MorrisMA/MAM65C02-Processor-Core/Docs/Images/M65C02-TestBoard-20130703.JPG

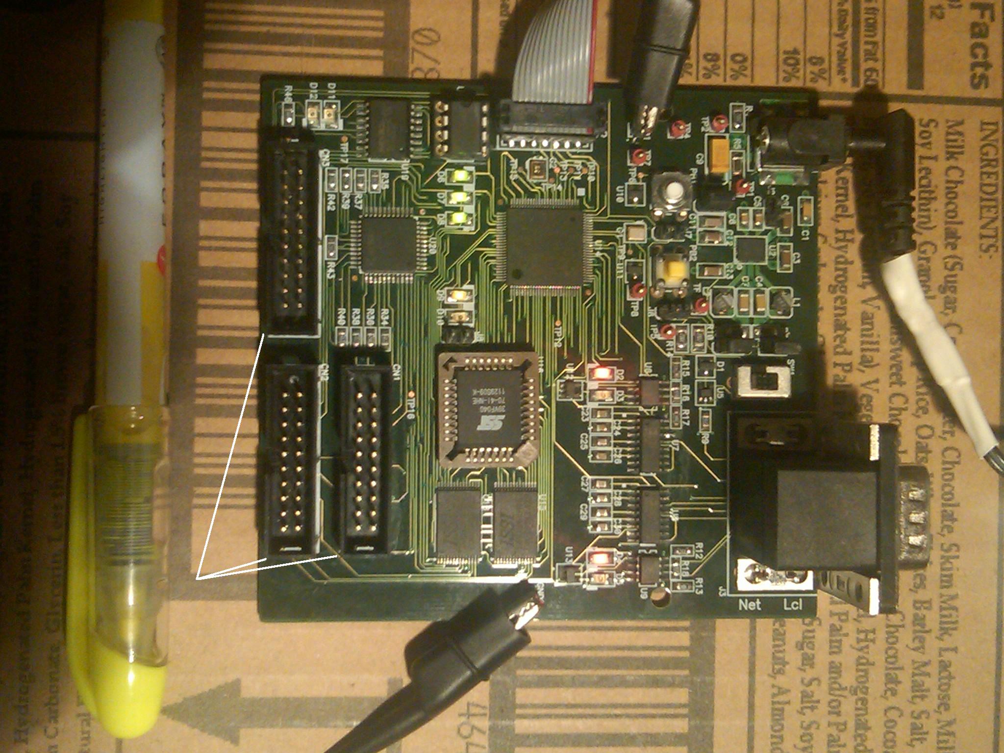
Docs/Images/M65C02-TestBoard-20130703.JPG
