MorrisMA/MAM65C02-Processor-Core/Docs/Images/M65C02_FlowControl_Immediate_Cycles.JPG

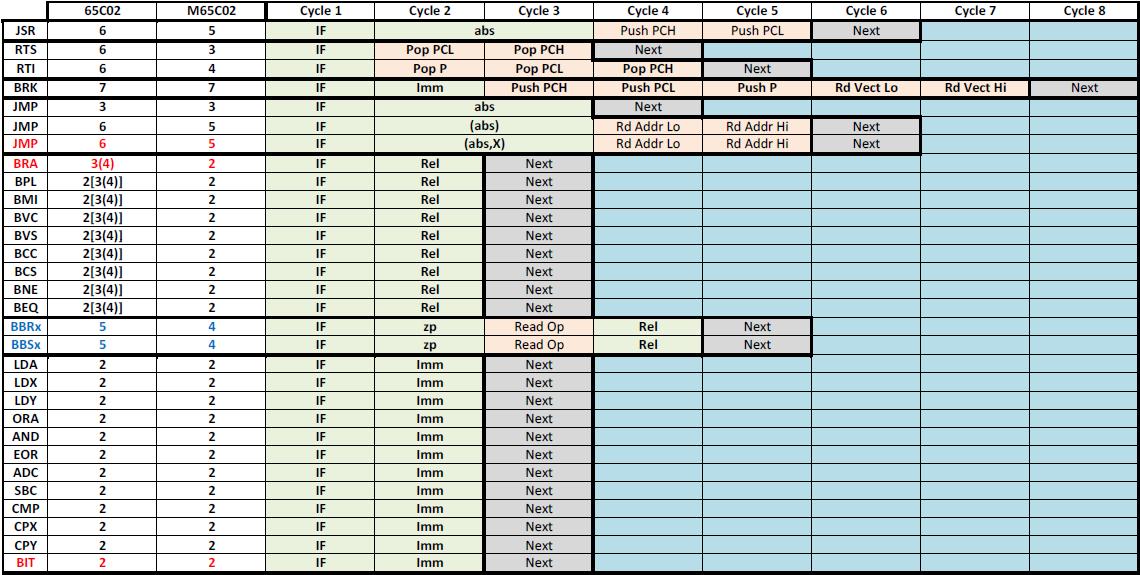
Docs/Images/M65C02_FlowControl_Immediate_Cycles.JPG
