MorrisMA/MAM65C02-Processor-Core/Docs/Images/FSM-BubbleDiagram.JPG

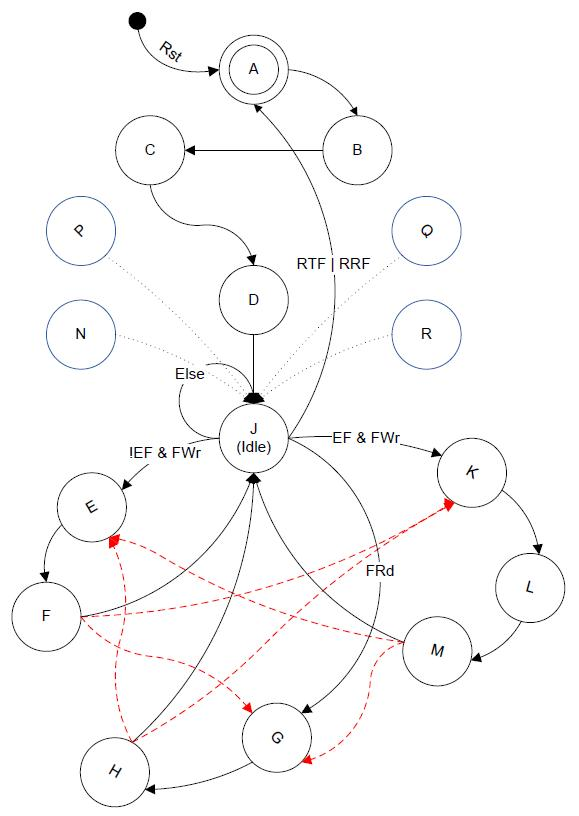
Docs/Images/FSM-BubbleDiagram.JPG
