MorrisMA/MAM65C02-Processor-Core/Docs/Images/M65C02 Timing Diagram.JPG

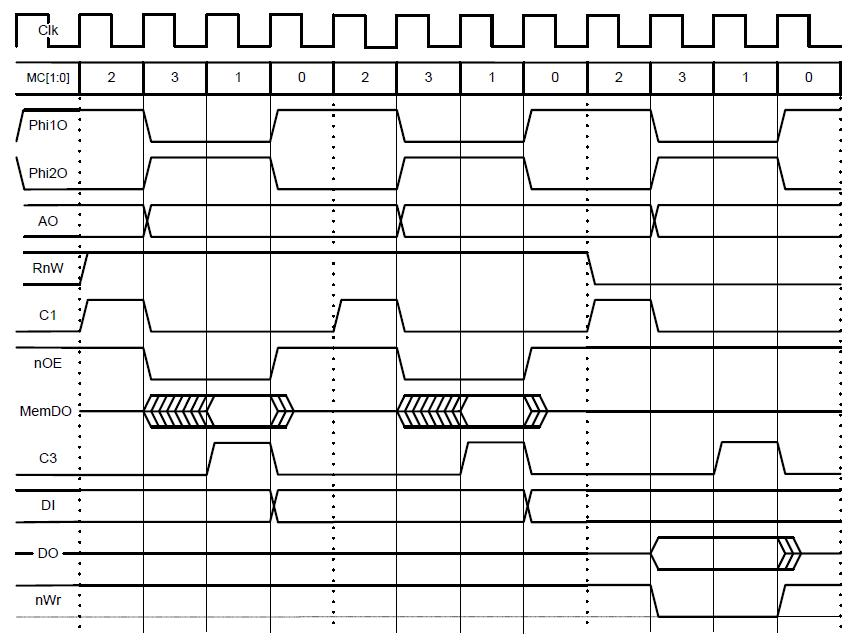
Docs/Images/M65C02 Timing Diagram.JPG
