MorrisMA/MAM65C02-Processor-Core/Docs/Images/M65C02_abs_absX_absY_Cycles.JPG

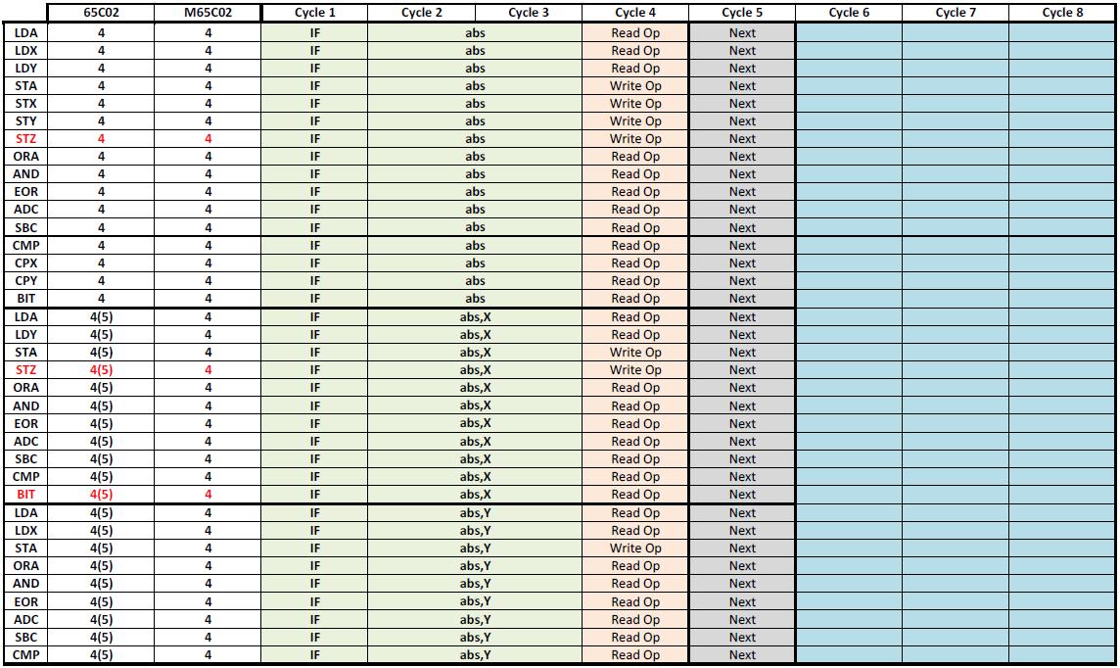
Docs/Images/M65C02_abs_absX_absY_Cycles.JPG
