MorrisMA/MAM65C02-Processor-Core/Docs/Images/M65C02_Core.JPG

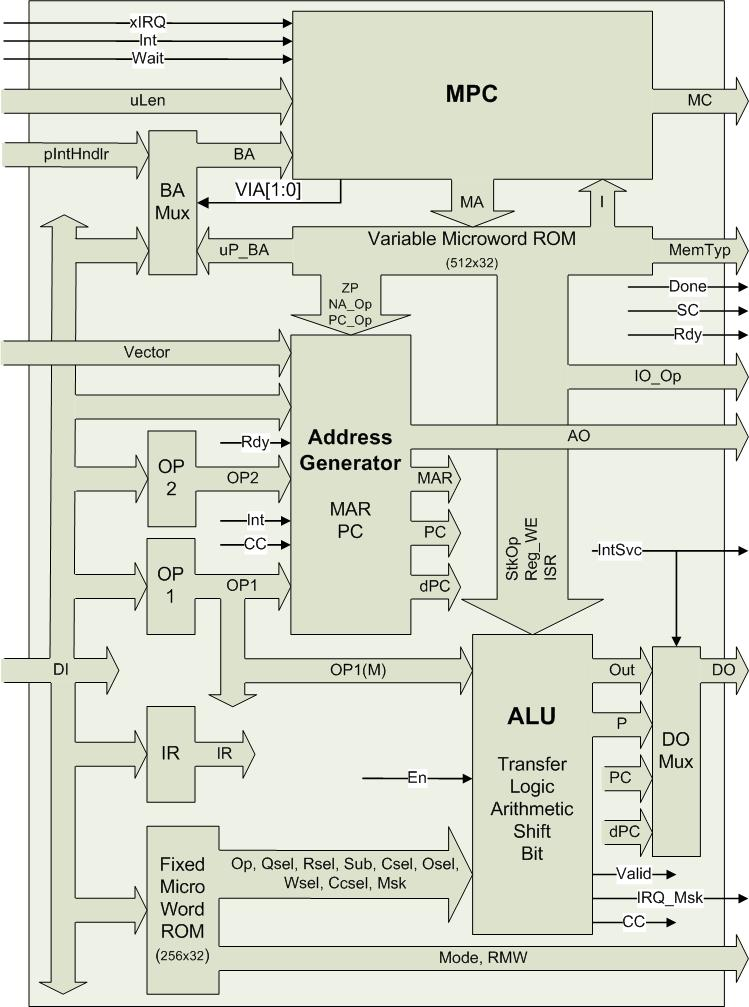
Docs/Images/M65C02_Core.JPG
