MorrisMA/MAM65C02-Processor-Core/Docs/Images/M65C02_Implicit_Accumulator_Cycles.JPG

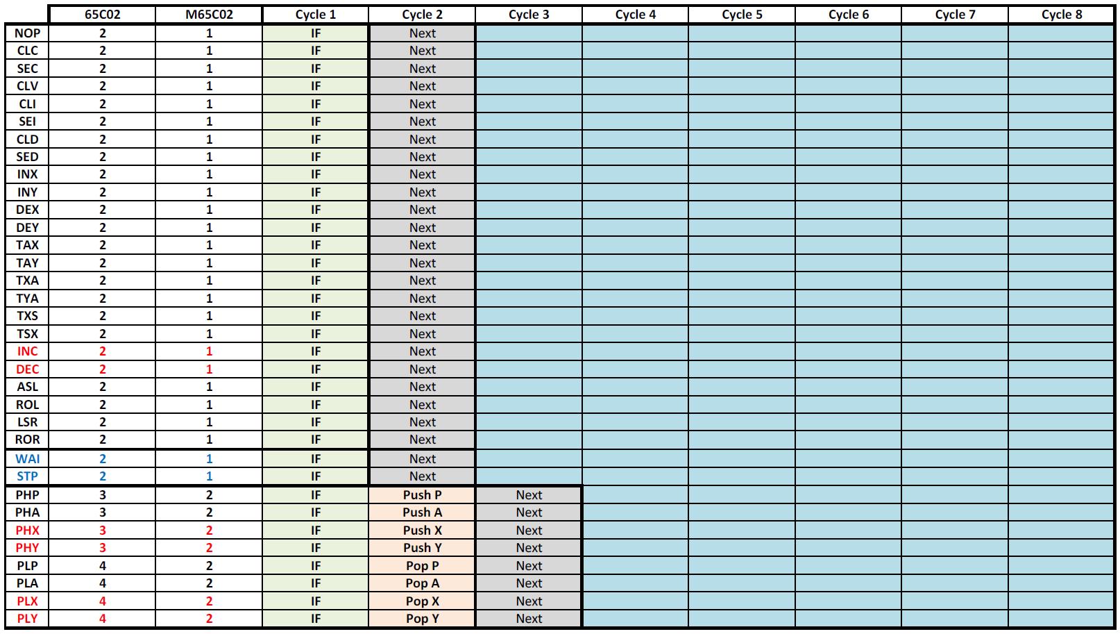
Docs/Images/M65C02_Implicit_Accumulator_Cycles.JPG
