MorrisMA/MAM65C02-Processor-Core/Docs/Images/M65C02_MPC.JPG

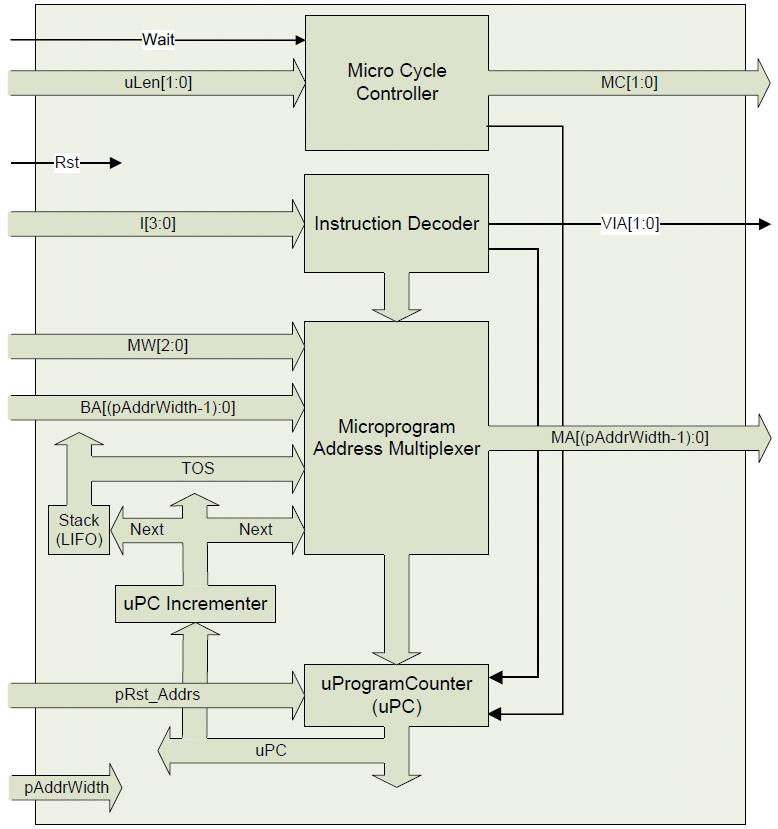
Docs/Images/M65C02_MPC.JPG
