MorrisMA/MAM65C02-Processor-Core/Docs/Images/M65C02_RMW_zp_zpX_abs_absX_Cycles.JPG

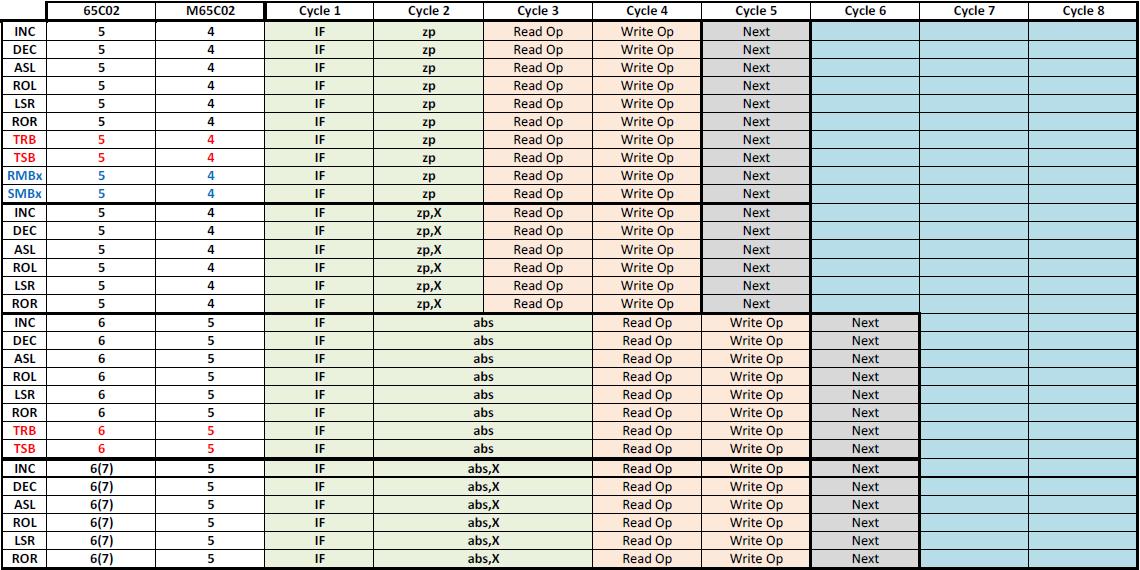
Docs/Images/M65C02_RMW_zp_zpX_abs_absX_Cycles.JPG
