MorrisMA/MAM65C02-Processor-Core/Docs/Images/M65C02_zp_zpX_Cycles.JPG

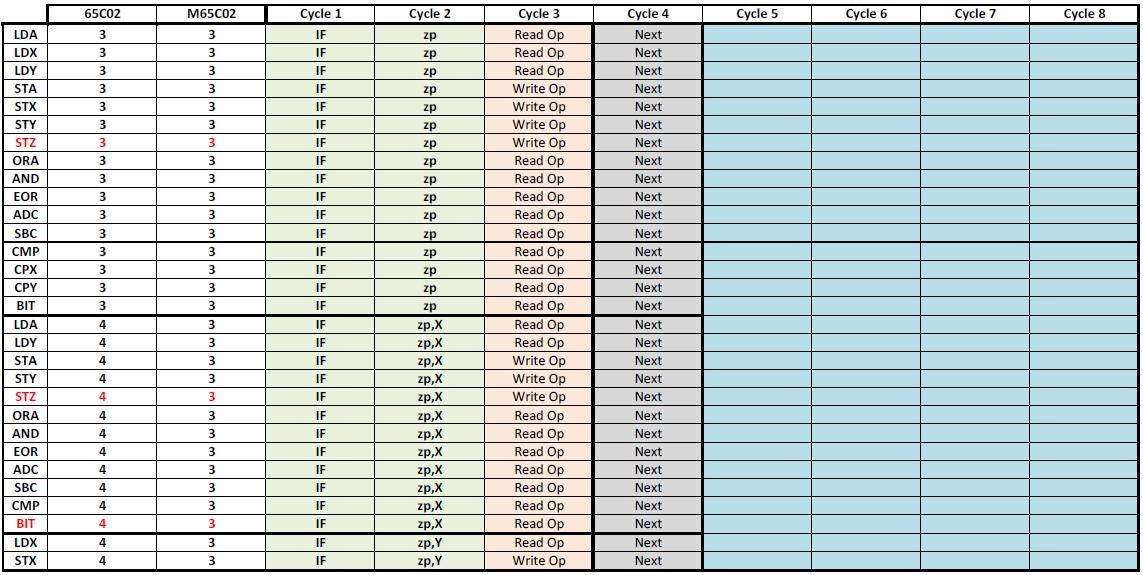
Docs/Images/M65C02_zp_zpX_Cycles.JPG
