MorrisMA/MAM65C02-Processor-Core/Docs/Images/M65C02_zpI_zpXI_zpIY_Cycles.JPG

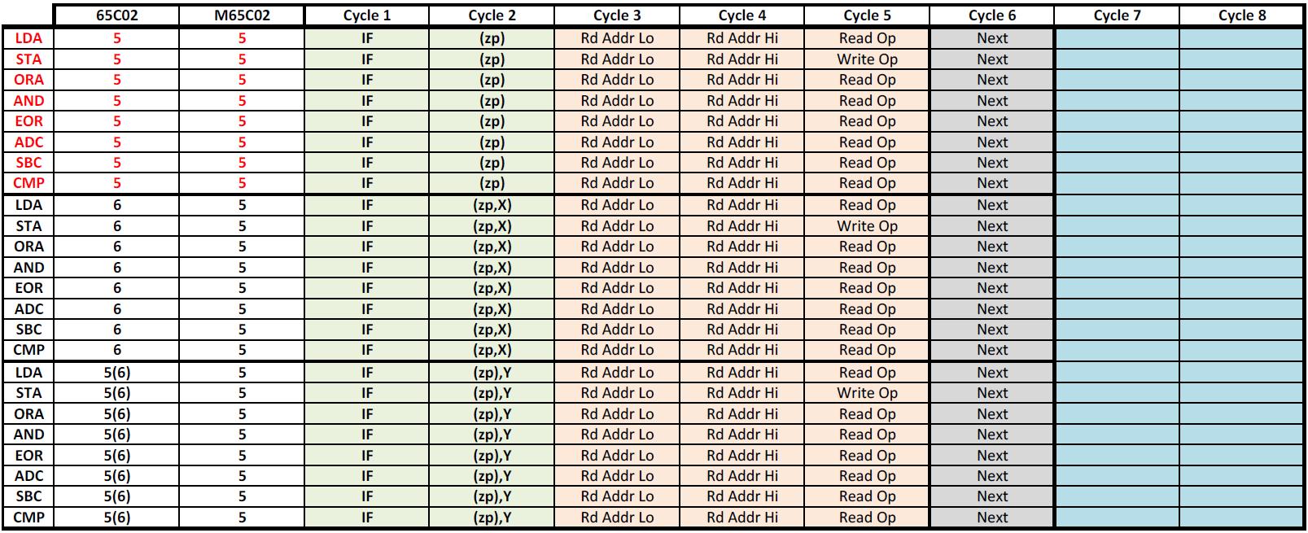
Docs/Images/M65C02_zpI_zpXI_zpIY_Cycles.JPG
