MorrisMA/MAM65C02-Processor-Core/(threads)

Thread 6 (2015-11-17):

Ability to use either VHDL or Verilog style comments

jwdonal, 2015-11-17:
It would be nice to have the option of using either VHDL or Verilog style comments (even if it didn't support block comments). The forward slash '/' operator doesn't seem to have any special meaning in the current implementation so it would seem trivial to accept either "--" or "//" as a comment line.

Closed 2016-09-18.
