MorrisMA/MAM65C02-Processor-Core/(commit log)

2012-04-28 Initial Release of Microprogrammed of 65C02-compatible core logic for FPGA implementations.
    [BCD_Addition_Subtraction.xls, F8051-Notes.xls]
2012-05-15 Edited the Utils Readme to include information pertaining the the SMRTool microprogram assembler.
2012-11-27 Added interrupt interfaces, Rdy, etc. Module interfaces complete.
2013-02-16 Corrected Wait field for WAI. Cut & paste error from M65C02_uPgm_V3a.txt
2013-08-13 Replaced Obsolete Opcode Map Spreadsheet
    [F8051-Notes.xls, M65C02-Notes.xls]
2013-08-31 Updated to latest working sources. Modularized the M65C02 implementation with clock generator and interrupt handler modules.
    [BCD_Addition_Subtraction.xls, M65C02-Notes.xls]
2013-09-04 Updated Spreadsheet and created PDF opcode matrix
    [M65C02-Notes.xls]
